cvaldess/Rpi3FanHatPlus/HATPlus/PCB-2D.JPG

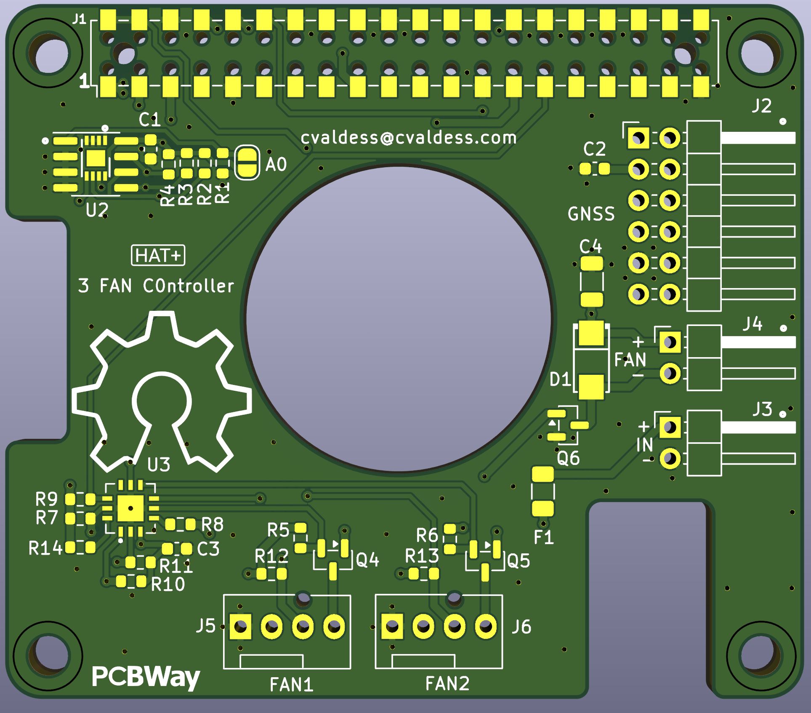
HATPlus/PCB-2D.JPG
