cvaldess/Rpi3FanHatPlus/HATPlus/fab/HAT+-BOM-PCBWay.csv

Designator | Qty | Manufacturer | Mfg Part # | Description/Value | Package/Footprint | LCSC Part #
C1,C2,C3 | 3 | Yageo | CC0603KRX7R9BB104 | 100n 50V | Capacitor_SMD:C_0603_1608Metric | C14663
C4 | 1 | Samsung Electro-Mechanics | CL31A106KBHNNNE | 10u 50V | Capacitor_SMD:C_1206_3216Metric | C13585
D1 | 1 | MDD(Microdiode Semiconductor) | SS14 | SS14 | easyeda2kicad:SMA_L4.3-W2.6-LS5.1-RD | C2480
F1 | 1 | JDTfuse | ASMD1206-050-30V | 0.5A | Fuse:Fuse_1206_3216Metric | C2982267
J1 | 1 | Samtec | HLE-120-02-F-DV-BE-A | RPi_40Pin | Connector_Samtec_Reverse:Samtec_HLE-120-02-xxx-DV-BE-A_2x20_P2.54mm_Horizontal_Reverse | C3319272
J2 | 1 | XFCN | PZ254R-12-12P | GNSS | Connector_PinHeader_2.54mm:PinHeader_2x06_P2.54mm_Horizontal | C492434
J3 | 1 | XFCN | PZ254R-11-02P | 12V | Connector_PinHeader_2.54mm:PinHeader_1x02_P2.54mm_Horizontal | C492410
J4 | 1 | XFCN | PZ254R-11-02P | Fan3 | Connector_PinHeader_2.54mm:PinHeader_1x02_P2.54mm_Horizontal | C492410
J5 | 1 | Molex | 47053-1000 | FAN1 | Connector:FanPinHeader_1x04_P2.54mm_Vertical | C240840
J6 | 1 | Molex | 47053-1000 | FAN2 | Connector:FanPinHeader_1x04_P2.54mm_Vertical | C240840
Q4,Q5 | 2 | JSCJ | 2N7002 | 2N7002 | Package_TO_SOT_SMD:SOT-23 | C8545
Q6 | 1 | Alpha & Omega Semicon | AO3400A | AO3400A | Package_TO_SOT_SMD:SOT-23 | C20917
R1,R2,R3,R4 | 4 | HWA CHN | HRC0603F3901ENTN | 3.9k | Resistor_SMD:R_0603_1608Metric | C54920913
R5,R6,R7,R8,R9,R10,R11 | 7 | HWA CHN | HRC0603F4701ENTN | 4.7K | Resistor_SMD:R_0603_1608Metric | C54920925
R12,R13 | 2 | HWA CHN | HRC0603F2201ENTN | 2.2K | Resistor_SMD:R_0603_1608Metric | C54920892
R14 | 1 | UNI-ROYAL(Uniroyal Elec) | 0603WAF1002T5E | 10K | Resistor_SMD:R_0603_1608Metric | C25804
U1 | 1 | MICROCHIP | AT24CS64-SSHM-B | AT24CS64-SSHM | Package_SO:SOIC-8_3.9x4.9mm_P1.27mm | C615478
U3 | 1 | MICROCHIP(美国微芯) | EMC2303-1-KP-TR | EMC2303-1-KP-TR | libs:TQFN-12_L4.0-W4.0-P0.80-BL-EP2.1_PasteGrid | C621414
