cvaldess/Rpi3FanHatPlus/HATPlus/HAT+.kicad_pcb

## KiCad design HATPlus/HAT+.kicad_pcb (2026-10-25)

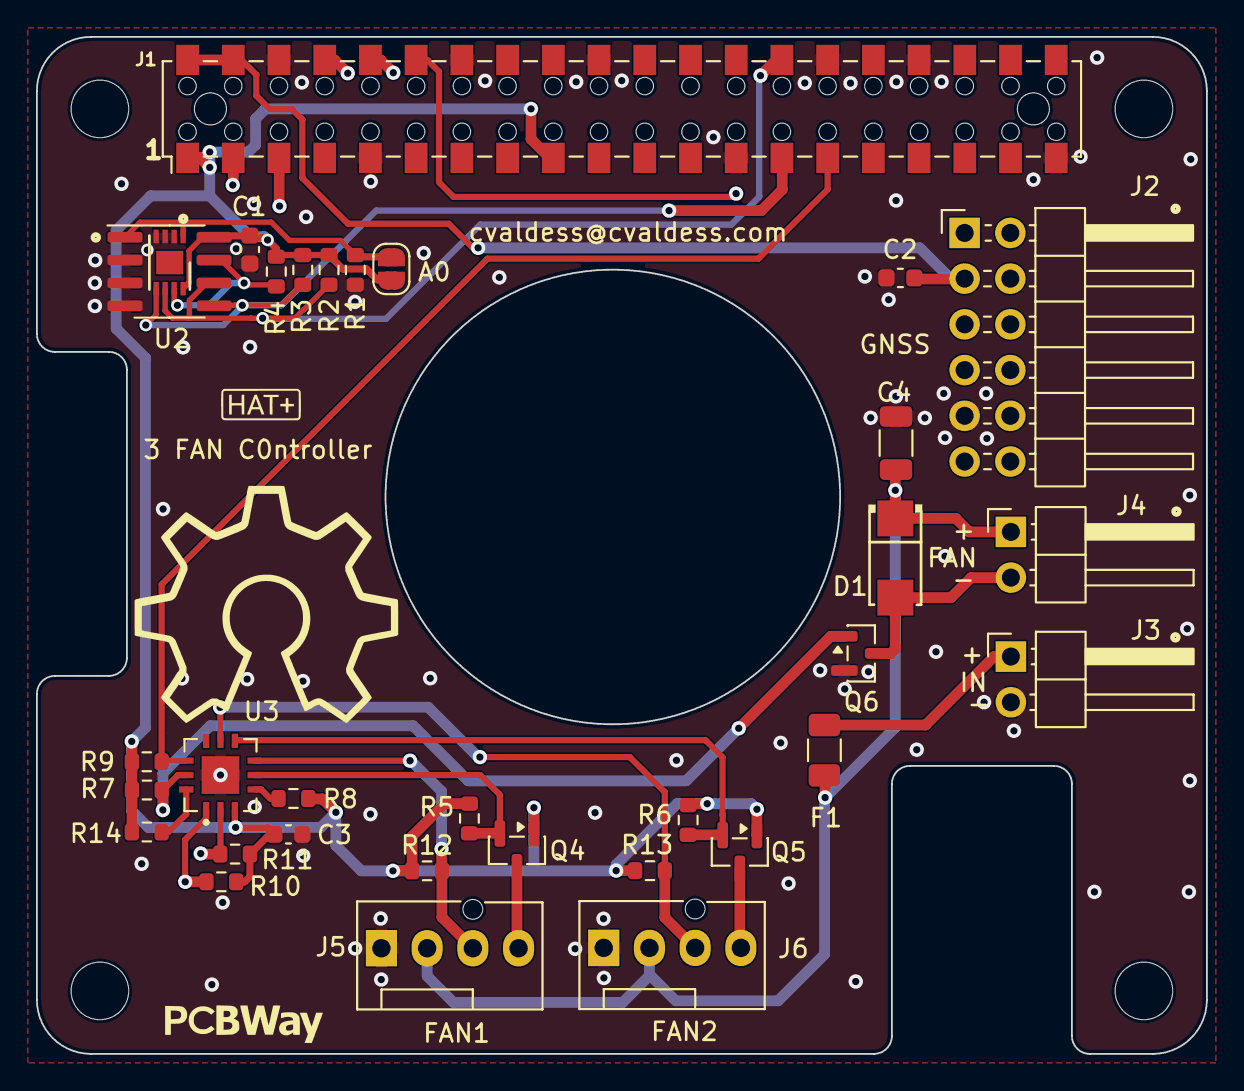
[picture p3: board HAT+.kicad_pcb from above]

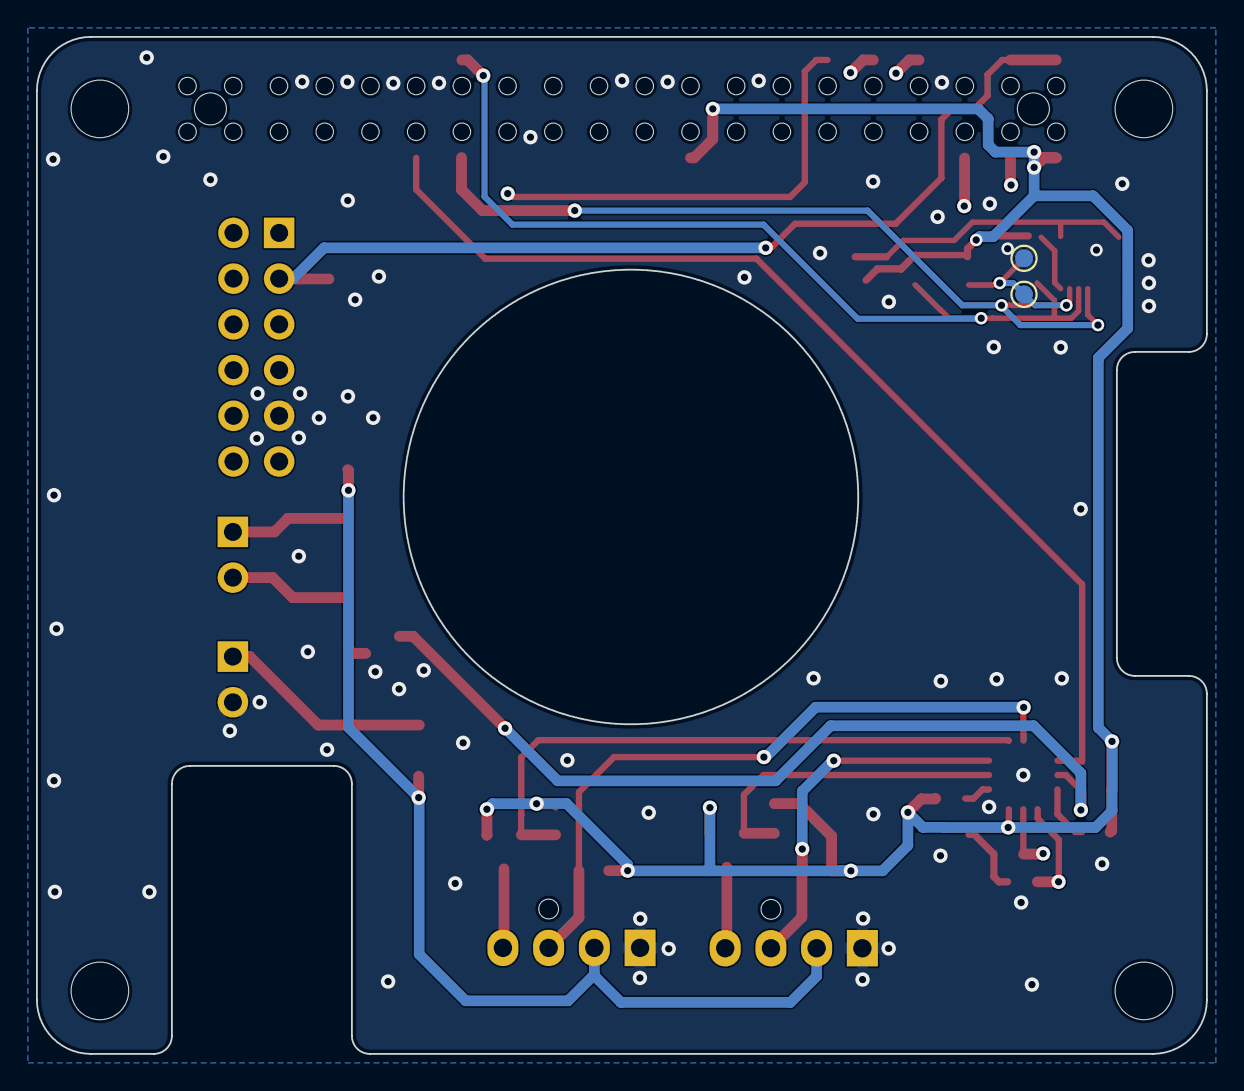
[picture p4: board HAT+.kicad_pcb from below]

Board: 4 copper layers, 65.0 x 56.5 mm, 39 parts (2 on the bottom side), 25 nets.

Parts:
A0: SolderJumper_2_Open; SolderJumper-2_P1.3mm_Open_RoundedPad1.0x1.5mm
C1, C2, C3: 100n 50V; C_0603_1608Metric
C4: 10u 50V; C_1206_3216Metric
D1: SS14; SMA_L4.3-W2.6-LS5.1-RD
F1: 0.5A; Fuse_1206_3216Metric
GND1: TestPoint_Alt; TestPoint_Pad_D1.0mm
H1, H2, H3, H4: MountingHole 3.2mm; MountingHole_3.2mm_M3_DIN965
J1: RPi_40Pin; Samtec_HLE-120-02-xxx-DV-BE-A_2x20_P2.54mm_Horizontal_Rever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
J2: GNSS; PinHeader_2x06_P2.54mm_Horizontal
J3: 12V; PinHeader_1x02_P2.54mm_Horizontal
J4: Fan3; PinHeader_1x02_P2.54mm_Horizontal
J5: FAN1; FanPinHeader_1x04_P2.54mm_Vertical
J6: FAN2; FanPinHeader_1x04_P2.54mm_Vertical
Q4, Q5: 2N7002; SOT-23
Q6: AO3400A; SOT-23
R1, R2, R3, R4: 3.9k; R_0603_1608Metric
R5, R6, R7, R8, R9, R10, R11: 4.7K; R_0603_1608Metric
R12, R13: 2.2K; R_0603_1608Metric
R14: 10K; R_0603_1608Metric
U1: AT24CS64-SSHM; SOIC-8_3.9x4.9mm_P1.27mm
U2: AT24CS64-MAHM; DFN-8-1EP_3x2mm_P0.5mm_EP1.3x1.5mm
U3: EMC2303-1-KP-TR; TQFN-12_L4.0-W4.0-P0.80-BL-EP2.1_PasteGrid
WP1: TestPoint_Alt; TestPoint_Pad_D1.0mm

Connections:
/Fan Controller/+3V3: A0.2 (B), C1.1, C3.1, J1.1, J1.17, Q4.1 (G), Q5.1 (G), R2.2, R3.2, R4.2, R5.1, R6.1, R7.1, R8.1, R9.1, R10.1, R11.1, R12.1, R13.1, R14.1, U1.8 (VCC), U2.8 (VCC), U3.3 (VDD)
/Fan Controller/+12V_BUS: F1.1, J3.1
/Fan Controller/+12V_FAN: C4.1, D1.1 (K), F1.2, J4.1, J5.2 (+), J6.2 (+)
/Fan Controller/ADDR_SEL: R8.2, U3.4 (ADDR_SEL)
/Fan Controller/ALERT: J1.29, R9.2, U3.10 (~ALERT)
/Fan Controller/FAN_DRV1: Q4.2 (S), R5.2, U3.5 (PWM1)
/Fan Controller/FAN_DRV2: Q5.2 (S), R6.2, U3.7 (PWM2)
/Fan Controller/FAN_DRV3: Q6.1 (G), R7.2, U3.11 (PWM3)
/Fan Controller/FAN_PWM1: J5.4 (PWM), Q4.3 (D)
/Fan Controller/FAN_PWM2: J6.4 (PWM), Q5.3 (D)
/Fan Controller/FAN_TACH1: J5.3 (Tacho), R12.2, U3.6 (TACH1)
/Fan Controller/FAN_TACH2: J6.3 (Tacho), R13.2, U3.8 (TACH2)
/Fan Controller/FAN_TACH3: R14.2, U3.12 (TACH3)
/Fan Controller/FAN_V-: D1.2 (A), J4.2, Q6.3 (D)
/Fan Controller/I2C_SCL: J1.5, R11.2, U3.2 (SMCLK)
/Fan Controller/I2C_SDA: J1.3, R10.2, U3.1 (SMDATA)
/GNSS/GPIO14_TXD: J1.8, J2.5
/GNSS/GPIO15_RXD: J1.10, J2.7
/GNSS/GPIO18_PCM_CLK: J1.12, J2.1
/GNSS/HAT_5V0: C2.1, J1.2, J1.4, J2.3
/HAT+/GPIO0_ID_SDA0: J1.27, R3.1, U1.5 (SDA), U2.5 (SDA)
/HAT+/GPIO1_ID_SCL0: J1.28, R2.1, U1.6 (SCL), U2.6 (SCL)
GND: C1.2, C2.2, C3.2, C4.2, GND1.1 (1_1), J1.6, J1.9, J1.14, J1.20, J1.25, J1.30, J1.34, J1.39, J2.9, J3.2, J5.1 (-), J6.1 (-), Q6.2 (S), R1.1, U1.2 (A1), U1.3 (A2), U1.4 (GND), U2.2 (A1), U2.3 (A2), U2.4 (GND), U3.13 (EP)
unnamed: A0.1 (A), R1.2, U1.1 (A0), U2.1 (A0)
unnamed: R4.1, U1.7 (WP), U2.7 (WP), WP1.1 (1_1)
