cvaldess/Rpi3FanHatPlus/(commit log)

2026-10-25 Rpi3FanHatPlus rev 1: Raspberry Pi 5 HAT+ fan controller and GNSS breakout
    KiCad 10 project for a HAT+ that drives three case fans with an EMC2303
    (two 4-pin PWM fans and one 2-wire fan) and connects a GNSS module to the
    Pi through J2 (UART0, PPS on GPIO18). Includes Gerber/drill zip, BOM and
    placement files prepared for PCBWay. Based on the HAT+ template by
    Helge Wurst; licensed under CERN-OHL-S v2.
    [HAT+-BOM-PCBWay.csv, HAT+.kicad_pcb, HAT+.kicad_sch, HAT_Plus_sch.kicad_sch, fan_controller.kicad_sch, gnss.kicad_sch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]
2026-10-26 Update README with PCBWay project link
    Added a link to PCBWay for project sharing.
